JitterCompany/f1-led-circuit/firmware/f1-logic/README.md

# F1 Logic

Generate binary driver dataset from csv file

```bash
cargo run --bin csv_to_bin --features use-std
```

Test deserialization

```bash
cargo run --bin deserialize_in_chunks --features use-std
```
