JitterCompany/f1-led-circuit/kicad/schematics_block_diagram/schematics_block_diagram_v3.png

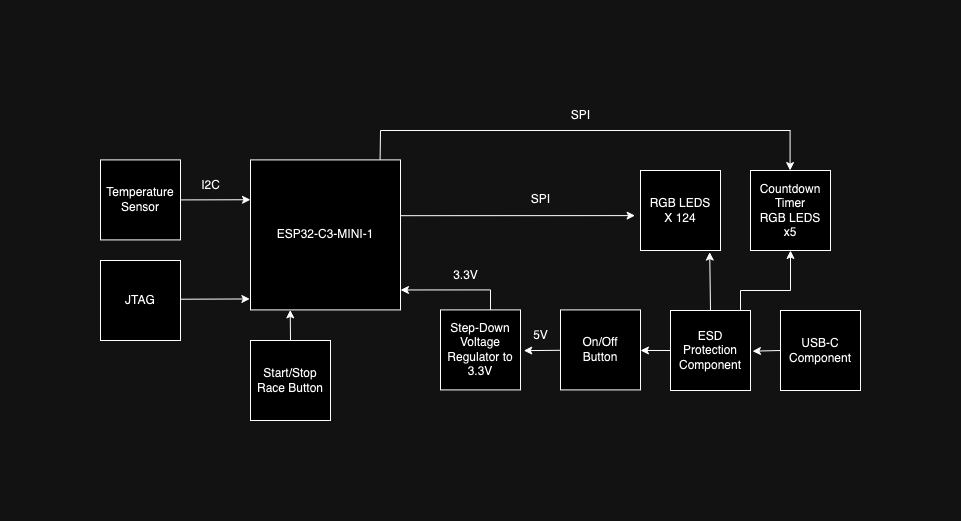
kicad/schematics_block_diagram/schematics_block_diagram_v3.png
