JitterCompany/f1-led-circuit/kicad/x_y_led_coords_zandvoort/zandvoort_kicad_import.png

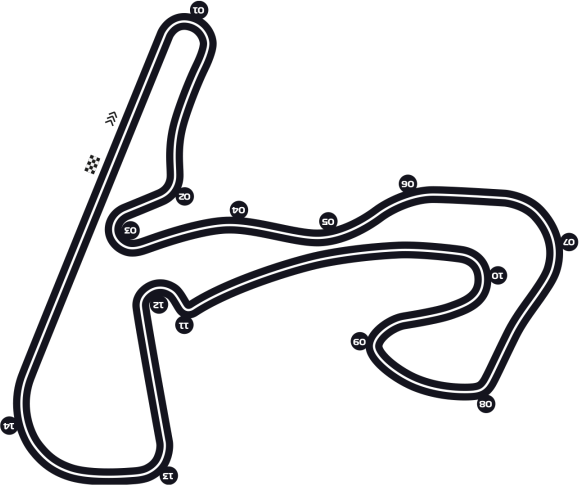
kicad/x_y_led_coords_zandvoort/zandvoort_kicad_import.png
