JitterCompany/f1-led-circuit/kicad/3D models/USB4105-GF-A.STEP

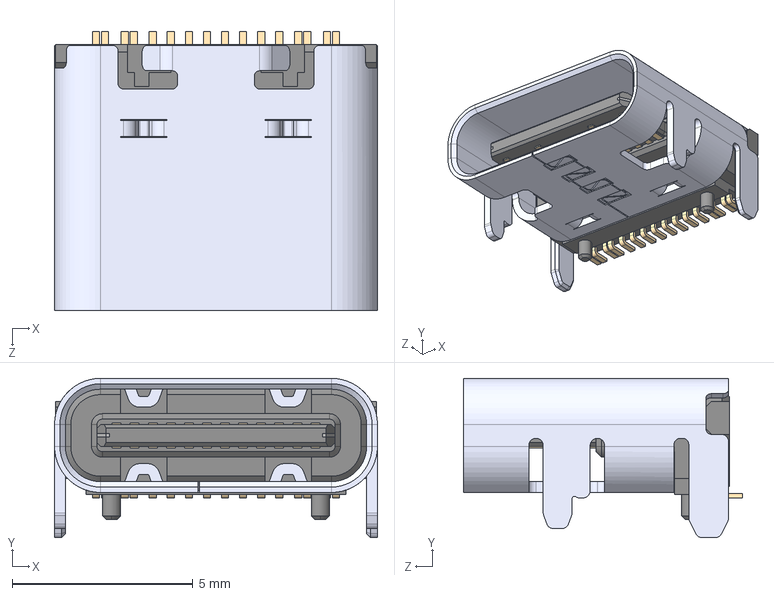
[picture p3: CAD file, 2024-05-20]
kicad/3D models/USB4105-GF-A.STEP
8.94 x 4.41 x 7.71 mm
