JitterCompany/f1-led-circuit/kicad/3D models/HD108-2020.step

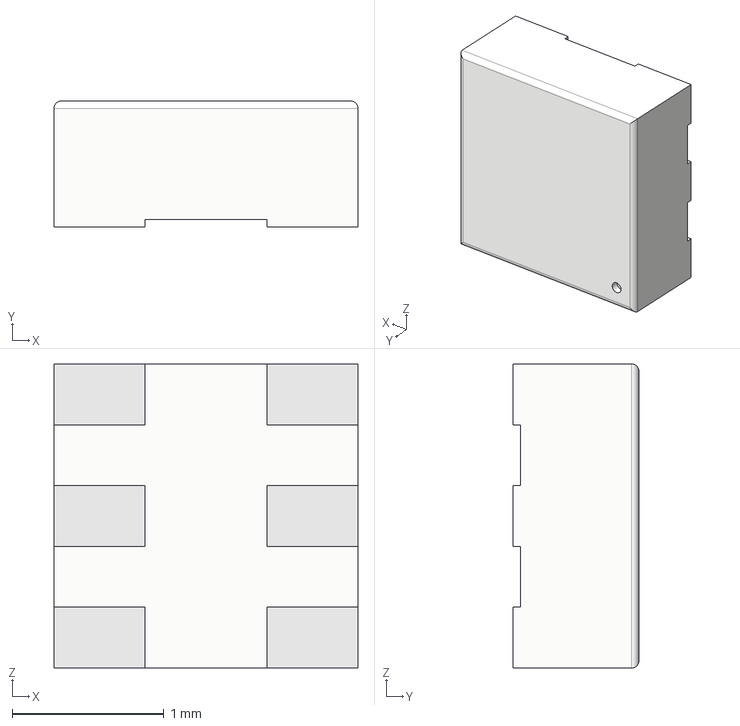
[picture p4: CAD file, 2024-05-20]
kicad/3D models/HD108-2020.step
2.00 x 0.83 x 2.00 mm
