JitterCompany/f1-led-circuit/kicad/3D models/ESP32-C3-MINI-1-N4.step

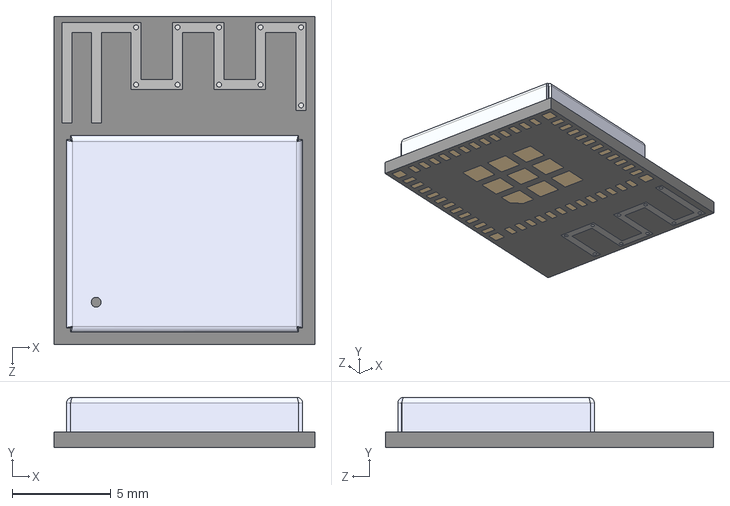
[picture p5: CAD file, 2024-05-20]
kicad/3D models/ESP32-C3-MINI-1-N4.step
13.2 x 2.55 x 16.6 mm
