JitterCompany/f1-led-circuit/kicad/3D models/TSM085P03CV.step

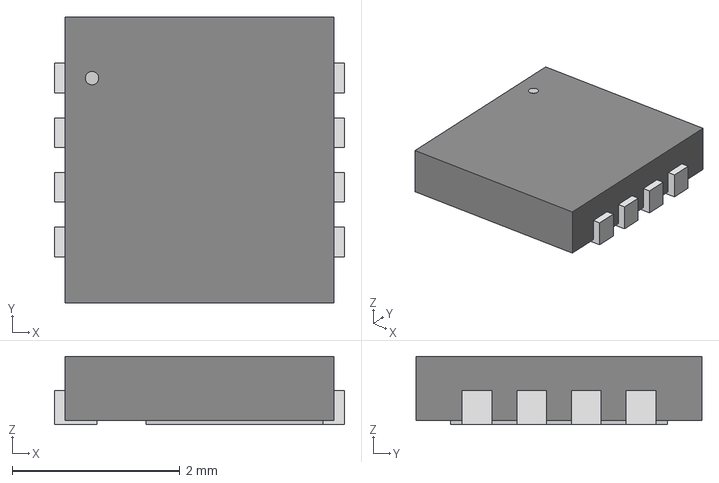
[picture p6: CAD file, 2024-05-20]
kicad/3D models/TSM085P03CV.step
3.45 x 3.40 x 0.815 mm
