JitterCompany/f1-led-circuit/kicad/3D models/LDLN050PU33R.step

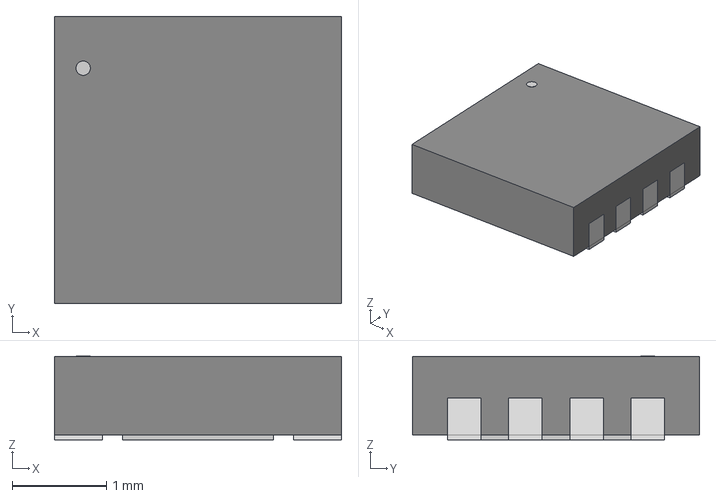
[picture p7: CAD file, 2024-05-20]
kicad/3D models/LDLN050PU33R.step
3.05 x 3.05 x 0.892 mm
