JitterCompany/f1-led-circuit/kicad/3D models/FTSH-105-01-L-DV-K-TR.step

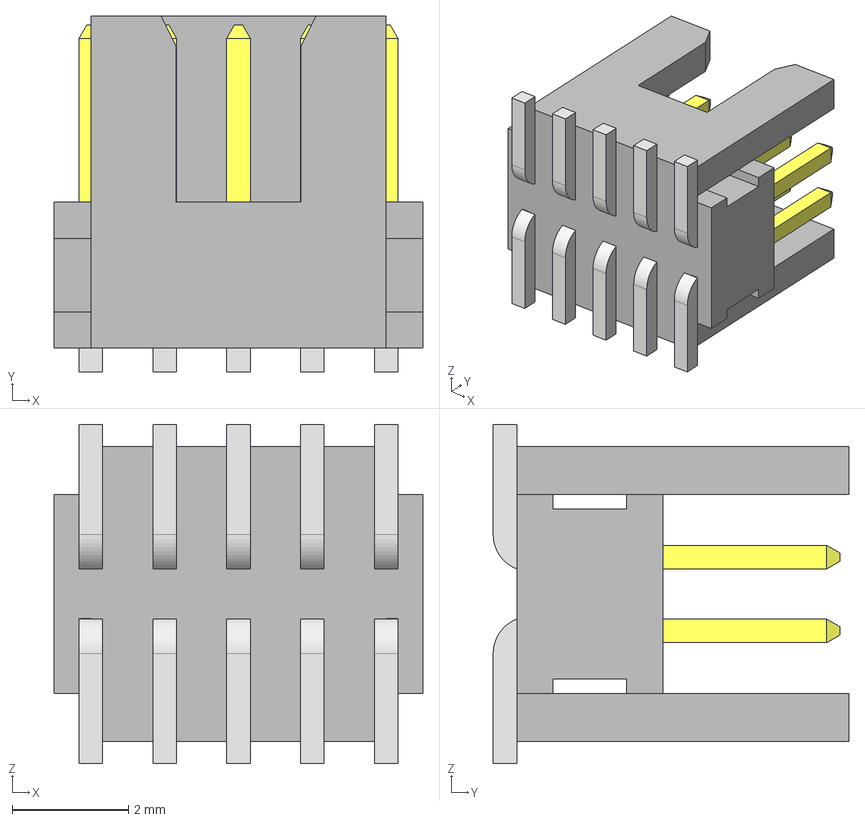
[picture p8: CAD file, 2024-05-20]
kicad/3D models/FTSH-105-01-L-DV-K-TR.step
6.35 x 6.12 x 5.84 mm
FTSH-105-01-L-DV-K-TR_body
FTSH-105-01-L-DV-K-TR_pins1
FTSH-105-01-L-DV-K-TR_pins2
