JitterCompany/f1-led-circuit/kicad/3D models/AS13AP.stp

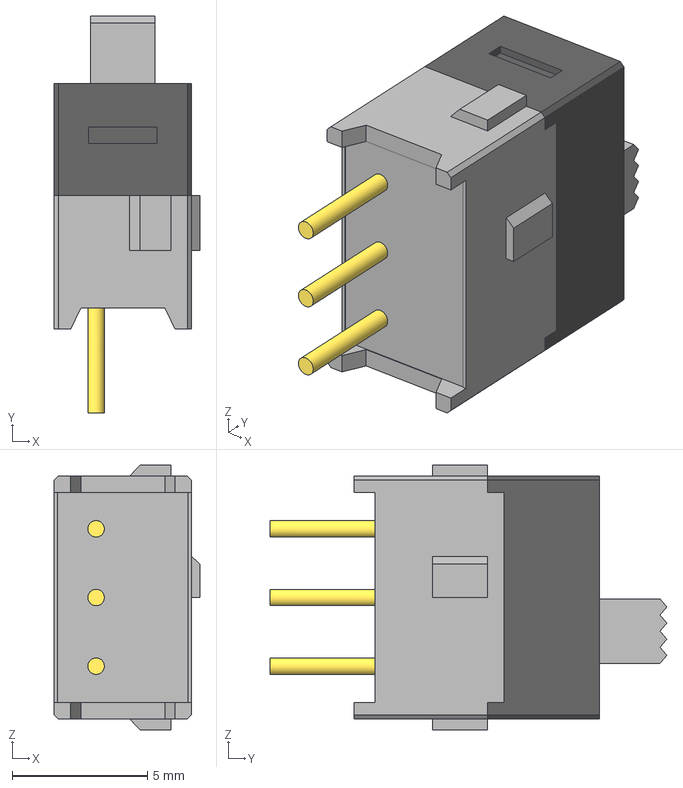
[picture p9: CAD file, 2024-05-20]
kicad/3D models/AS13AP.stp
5.38 x 14.7 x 9.80 mm
AS13APbody12
AS13APbody1
AS13APalong
AS13APp
