JitterCompany/f1-led-circuit/kicad/3D models/NUF2042XV6T1G.STEP

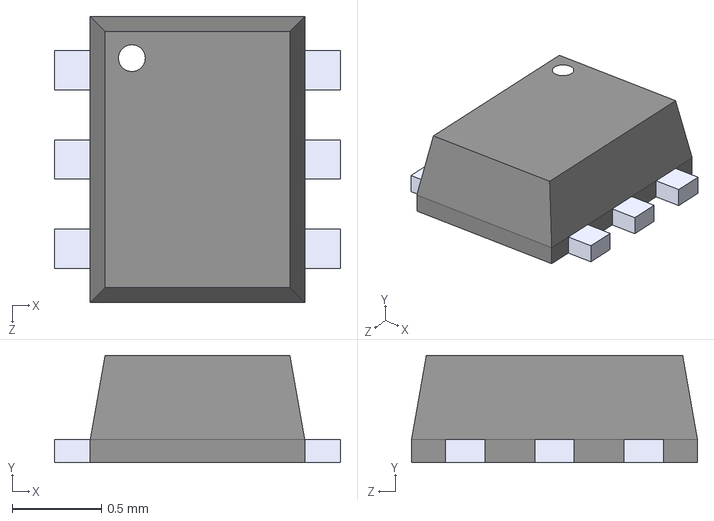
[picture p10: CAD file, 2024-04-30]
kicad/3D models/NUF2042XV6T1G.STEP
1.60 x 0.6 x 1.60 mm
