JitterCompany/f1-led-circuit/kicad/3D models/430182043816.stp

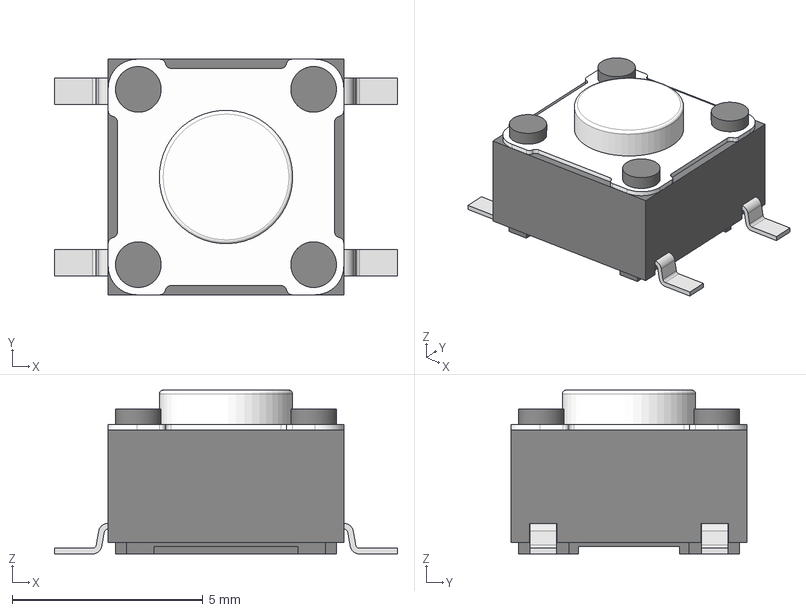
[picture p11: CAD file, 2024-05-20]
kicad/3D models/430182043816.stp
9.00 x 6.20 x 4.30 mm
