JitterCompany/f1-led-circuit/kicad/3D models/430182070816.stp

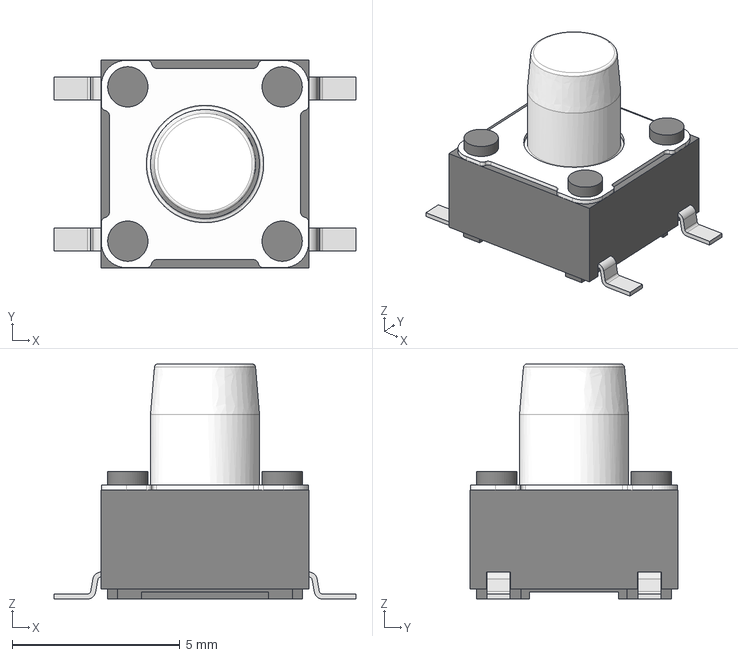
[picture p12: CAD file, 2024-05-20]
kicad/3D models/430182070816.stp
9.00 x 6.20 x 7.00 mm
