JitterCompany/f1-led-circuit/(threads)

Thread 1 (2024-04-01):

Select Microcontroller

CodingInGreen, 2024-04-01:

CodingInGreen, 2024-04-01:
I have experience getting Wifi connectivity working on an ESP32C3, which also supports  2.4 GHz Wi-Fi (802.11 b/g/n) and Bluetooth Low Energy (BLE) 5.0.

CodingInGreen, 2024-04-02:
probe-rs issue resolved, problem was caused by outdated probe-rs version. Board could be a good candidate.

CodingInGreen, 2024-04-03:
The design is open-source and we have the KiCAD files here:
https://github.com/esp-rs/esp-rust-board

ESP32-C3-MINI-1 comes with a PCB Antenna
ESP32-C3-MINI-1U comes with an external Antenna Connector

Power Supply Voltage:
Min: 3V
Typ: 3.3V
Max: 3.6V

ijager, 2024-04-03:
Does this part work well with RTIC and or Embassy?

CodingInGreen, 2024-04-03:
> Does this part work well with RTIC and or Embassy?

It works well with Embassy, I haven't tried RTIC with this specific MCU.

ijager, 2024-04-03:
Seems like the C3 is the only part in the ESP family that currently works with RTIC (due to the mcu architecture). And they also work with Embassy

I think this is good choice.

CodingInGreen, 2024-04-03:
Found a bug -- https://github.com/rtic-rs/rtic/pull/913

Someone in the chat notified me but I didn't see it until after, of a separate PR that covers it already that hasn't yet been merged -- https://github.com/rtic-rs/rtic/pull/906

haha, seems like we're probably set on RTIC as well. There's an updated example in #906 that I'll test out tomorrow.

CodingInGreen, 2024-04-09:
We've decided to choose the esp32c3 for our MCU.

Reasons why:

- 2.4 GHz Wi-Fi (802.11b/g/n) and Bluetooth® 5 (LE)
- Plays nicely with Embassy
- Configurable clock frequency with a maximum of 120 MHz in Single Transfer Rate (STR) mode (speedy enough for our LEDs)
- Adam has experience with esp32c3 through the dev kit: ESP32-C3-DevKit-RUST-1

CodingInGreen, 2024-04-14:
ESP32-C3-MINI-1 Selected

Closed 2024-04-14.

Thread 2 (2024-04-01):

Select LED

CodingInGreen, 2024-04-01:
We want to use addressable LEDs.

As far as we know there are two versions:

* Neopixel (WS2812, WS2813...)
* APA102
* ... Maybe there others?

They work with different protocols.

To make a selection we should make an overview of the available parts and figure out the differences between them.

* dimensions
* power requirements
* maximum daisy chained length?
* protocol
* Are they recommended for new designs (by the manufacturer)?
* ...

CodingInGreen, 2024-04-01:
https://www.iodparts.eu/part/ws2812b-2020

WS2812B-2020
Worldsemi
SMD 2mm x 2mm
Protocol: NZR communication mode
The control integrated circuit and the LED share the only power source.
12mA operating current per channel.
Stock: 102,785
Days to Ship: 20 Days
Minimum Order Quantity: 4,500 ??

https://www.digikey.pt/pt/products/detail/sunled/XZDGCBDMERK150W-1/15288282?productid=15288282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

XZDGCBDMERK150W-1
SunLED
SMD 1 mm x 1 mm
Forward Current: 10mA
Protocol: Not sure if these can even be daisy chained.
Stock: 7,754
Ships Immediately

CodingInGreen, 2024-04-01:
After reviewing: https://www.superlightingled.com/blog/category/addressable-led-strips/addressable-led-ic-comparison/

I'm not 100% if WS2812B-2020 is the best. The 2x2mm form factor is super nice. Each LED draws up to 12mA per channel, so with a 5V/10A power supply that's 10A/36mA = 277.7 LEDs. Taking 80% of that to be conservative, that's 222 LEDs.

ijager, 2024-04-01:
Why is it "the best"?

Some things to consider:

* supply voltage
* Is there a supported maximum chained length?
* What is the maximum refresh rate (fps) for certain lengths of chains? Or maybe in reverse, say we want to achieve 30Hz, how long can we make the chain. (Here you can see why requirements are important to have).

It would be nice to make a nice markdown table with a row for each candidate. So we can compare and make a data driven decision.

CodingInGreen, 2024-04-02:
[led_comparison.xlsx](https://github.com/JitterCompany/f1-led-circuit/files/14832341/led_comparison.xlsx)

Added comparison chart for review.

CodingInGreen, 2024-04-02:
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

552 LEDs in total

CodingInGreen, 2024-04-03:
If there are 20 cars on the track at a time, with a maximum current draw of 20 mA per channel with 3 channels. Max draw per RGB LED is 60 mA x 20 cars = Max draw from LEDs for all cars = 1,200 mA or 1.2 A

CodingInGreen, 2024-04-03:
**WS2812B-2020**

The WS2812B-2020 LED utilizes a single-wire non-return-to-zero (NZR) communication mode, making its protocol highly sensitive to timing. This design means that the difference between transmitting a logic '0' or a '1' depends on precise timing intervals, which can introduce complexity in programming, especially on platforms with non-deterministic timing behavior. The protocol's timing sensitivity requires careful management of interrupts and timing functions to achieve stable color patterns and refresh rates, potentially complicating development on multitasking operating systems or environments with variable execution times.

**APA102C**

Conversely, the APA102C employs a two-wire protocol, similar to SPI, using separate data and clock lines, which significantly reduces timing sensitivity and programming complexity. This approach allows for more straightforward and reliable data transmission, making it less prone to errors from timing discrepancies. The inclusion of a clock line not only facilitates higher refresh rates by supporting faster data transmission but also enables the APA102C to operate with a broader range of microcontrollers and software environments, making it a more versatile choice for projects requiring robust and dynamic LED displays.

ijager, 2024-04-03:
This is great. I will inquire about availability and pricing for these parts so we weigh that into the selection.

ijager, 2024-04-03:
For power, assuming only 20 leds are on is too optimistic. We have to be able to handle turning on all LEDs, which can happen because of bugs or when people are going to run their own firmware on the board.

We can add a temperature sensor to monitor the board temperature and shut it down when it gets too hot.

CodingInGreen, 2024-04-04:
I recounted the LEDs for the track on the 300 x 300 pixel grid, and came up with 550 LEDs instead of 552.

550 LEDs x 60mA = 33,000mA or 33 Amps

CodingInGreen, 2024-04-08:
[led_comparison_updated.xlsx](https://github.com/JitterCompany/f1-led-circuit/files/14903831/led_comparison_updated.xlsx)

New Candidates:

SK9822-EC20(SK9822-2020)
APA107-2020
NS107S-2020
HD108-2020
EC20-6812 (SK6812-2020)

CodingInGreen, 2024-04-14:
HD108-2020 selected.

Closed 2024-04-14.

Thread 3 (2024-04-01):

Formulate Requirements

ijager, 2024-04-01:
Currently, we know the high level requirements vaguely. But we should write them down in a detailed and testable/measurable way.

CodingInGreen, 2024-04-04:
**Requirements**

- 20 LEDS for starting grid
- Countdown timer
- Connects to Wifi for any user's router
- Get a dataset outside of the system
- Have method to distinguish drivers
- Handle scenario where a car is out of race
- PCB shuts down if a maximum temperature is reached
- Passes standard EMC/ESD tests
- On/Off Button for User
- Start/Stop Button for User
- Show visual state of program - running or not
- Firmware should know its own version
- Firmware should be able to detect PCB version
- Debuggable with RTT
- Wall outlet to USB-C adapter
- LED driver is safe

Closed 2024-04-18.

Thread 5 (2024-04-11):

Select Temperature Sensor

CodingInGreen, 2024-04-11:
I have had a successful experience using an SHT31 temperature and humidity sensor using I2C.

SHT31:

[https://www.digikey.pt/pt/products/detail/sensirion-ag/SHT31-DIS-F2.5KS/6212137?productid=6212137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](url)

This is the crate I used:

https://crates.io/crates/sht31

ijager, 2024-04-11:
Is this crate usable in an async project?On 11 Apr 2024, at 18:30, Adam Hott ***@***.***> wrote:
I have had a successful experience using an SHT31 temperature and humidity sensor using I2C.
SHT31:
https://www.digikey.pt/pt/products/detail/sensirion-ag/SHT31-DIS-F2.5KS/6212137?productid=6212137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
This is the crate I used:
https://crates.io/crates/sht31

—Reply to this email directly, view it on GitHub, or unsubscribe.You are receiving this because you are subscribed to this thread.Message ID: ***@***.***>

CodingInGreen, 2024-04-14:
This builds successfully, I didn't connect my SHT31 sensor to the board to test though.

Would you like me to do that to see if I can get a reading?

https://github.com/CodingInGreen/esp32c3-embassy-sht31

CodingInGreen, 2024-04-15:
I will test the SHT31. Maybe the BME280 sensor would be a better choice.

This crate supports embedded-hal-async as well:
https://crates.io/crates/bme280-rs

I don't have a BME280 on hand, here is it available in Portugal (18,10 euros + shipping is about 5 euros = 23.10 euros).
https://mauser.pt/catalog/product_info.php?products_id=096-6714

It could arrive in 2-3 days.

CodingInGreen, 2024-04-15:
I had some trouble getting the readings on esp32c3, so I tested on the micro:bit V2.

I got an average time measurement: timestamp of data collection cycle - timestamp of new reading = 98 milliseconds.

The micro:bit V2 has a clock speed of 64 Mhz and the measurement frequency can be set up to 400 Mhz (limited by the IC2 setup on the micro:bit V2 crate).

The clock speed of esp32-c3-mini-1 is 160 Mhz, and the maximum measurement frequency of the SHT31 is 1 Mhz.

Calculate for estimate for the blocking time on the esp32-c3-mini-1:

CPU speed increase from 64 MHz to 160 MHz (a factor of 2.5)
I2C speed increase from 400 kHz to 1 MHz (a factor of 2.5)

Time reduction = 2.5 x 2.5 = 6.25

98 milliseconds (avg. time from micro:bit V2) / 6.25 = 15.68 milliseconds

Estimated average blocking time - around 15 milliseconds

CodingInGreen, 2024-04-18:
We went with MCP9701A as it's been successfully used in other projects, and has a margin of error that is acceptable.

Closed 2024-04-18.

Thread 6 (2024-04-15):

Select Power Adapter and Voltage Regulator/Buck Converter

CodingInGreen, 2024-04-15:
We need to calculate the maximum current consumption for the board and select the appropriate power adapter and voltage regulator/buck converter.

Closed 2024-04-18.

Thread 7 (2024-04-18):

Select Start/Stop Button

CodingInGreen, 2024-04-18:
[4301x2xxx8x6.pdf](https://github.com/JitterCompany/f1-led-circuit/files/15025002/4301x2xxx8x6.pdf)

Wurth Elektronik
Series: Tact Switches
Part Number: 430 182 070 816

Closed 2024-04-18.

Thread 18 (2024-05-22):

Zandvoort dataset for testing

CodingInGreen, 2024-05-22:
For the data pulled from https://openf1.org/

Attached is are the data points for the x, y, and z coordinates as well as the corresponding timestamp for Max Verstappen's results from the 2023 Dutch Grand Prix.

[zandvoort_data.csv](https://github.com/JitterCompany/f1-led-circuit/files/15403007/zandvoort_data.csv)

Here is how I generated this data:
https://github.com/CodingInGreen/f1-led-circuit-track-data

I attempted to plot the data here:
https://github.com/CodingInGreen/f1-led-circuit-track-plot/blob/main/zandvoort_track.png

But as you can see the plot doesn't represent anything close to the actual track's form.

There are positive and negative integers as the x and y coordinates, so we need to find the origin (0,0) for this data.

There is a separate project that is successfully mapping the data to the form of the track, it's open source, but they haven't yet built out the track for Zandvoort so you can see in this example if you select the 2023 race for the Zandvoort track the 3D car drives around without a track:
https://www.f1nsight.com/
https://github.com/adityakotha03/F1nsight

We discussed the possibility of live data streaming over Wifi. The owner of the openf1 repository says that there IS access to real-time data during the race.

https://github.com/br-g/openf1/discussions/46

CodingInGreen, 2024-05-23:
I was pulling in the incorrect track's dataset, the repository has been updated with the correct id and I was able to pull and plot the correct data. See https://github.com/JitterCompany/f1-led-circuit/issues/19

CodingInGreen, 2024-05-23:
Closing this to move over to Issue #19

Closed 2024-05-23.

Thread 19 (2024-05-23):

Mapping Zandvoort track data to led positions

CodingInGreen, 2024-05-23:
I first output to a .csv file the coordinates for the x,y positions of the LED footprints from KiCad. I set the origin to be offset by the KiCad x, y coordinate of the bottom left PCB edge corner, so that we'd be dealing with only positive x and y coordinates.

This is the script to get that data:
https://github.com/JitterCompany/f1-led-circuit/blob/master/kicad/x_y_led_coords_zandvoort/get_x_y_from_origin.py

I then output to a .csv file the dataset from the race data from Max Verstappen's 2023 Dutch Grand Prix at Zandvoort using program:
https://github.com/CodingInGreen/f1-led-circuit-track-data/blob/main/src/main.rs

I then plotted that data using this program:
https://github.com/CodingInGreen/f1-led-circuit-track-plot/blob/main/src/main.rs

Which gave me this plot:
https://github.com/CodingInGreen/f1-led-circuit-track-plot/blob/main/zandvoort_track_adjusted.png

I then normalized the x,y coordinates of the output from the KiCad led footprint positions to the track data using this program:
https://github.com/CodingInGreen/f1-led-circuit-normalize-data/blob/master/src/main.rs

And plotted the led positions using this program:
https://github.com/CodingInGreen/f1-led-circuit-plot-leds/blob/master/src/main.rs

Which gave me this plot:
https://github.com/CodingInGreen/f1-led-circuit-plot-leds/blob/master/led_plot_adjusted.png

The next step correlate the led positions with the track data.

CodingInGreen, 2024-05-23:
This program adds the LED designators to the x,y,timestamp data of the 2023 Zandvoort Max Verstappen data.

https://github.com/CodingInGreen/f1-led-circuit-nearest-neighbor/blob/master/src/main.rs

CodingInGreen, 2024-05-29:
I then used this program to combine the datasets of the actual race data and the x,y coordinates of the leds.

https://github.com/CodingInGreen/f1-led-circuit-combined-x-y-data

Thread 20 (2024-05-31):

KiCad PCB Layout - ESD Protection Component - NUF2042XV6T1G - footprint does not match component dimensions

CodingInGreen, 2024-05-31:
Here is the datasheet with the proper dimensions of the component:

[NUF2030XV6_D-2319419.pdf](https://github.com/user-attachments/files/15511314/NUF2030XV6_D-2319419.pdf)

In the current pcb layout the footprint dimensions are slightly off from the component dimensions.

We will hand solder the component as it is very close to fitting or leave it off the board.

CodingInGreen, 2024-08-05:
Fixed

Closed 2024-08-05.

Thread 21 (2024-06-14):

Create basic HD108 example

CodingInGreen, 2024-06-14:
Requirement - Turn one HD108-2020 LED of the f1-led-circuit board a specific RGB color.

CodingInGreen, 2024-06-15:
I found this documentation regarding migration from embedded-hal 0.2 to 1.0 regarding SpiDevice and SpiBus.

https://github.com/rust-embedded/embedded-hal/blob/master/docs/migrating-from-0.2-to-1.0.md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

CodingInGreen, 2024-06-15:
I worked on ensuring the correct traits from embedded-hal and embedded-hal-async were implemented. This included creating a wrapper around the spi instance to adapt it to the SpiBus trait required by the HD108 driver. It seems there is a mismatch between the expected traits between embedded-hal-async and the esp-hal library. The HD108 driver required an implementation of the SpiBus trait from embedded-hal-async, but the SPI implementation in esp-hal did not directly conform to this trait. The SpiBus trait has methods like read, write, transfer, transfer_in_place, and flush, which are asynchronous. The esp-hal library provides synchronous methods that needed to be wrapped or adapted. I had many attempts but was unable to successfully create a working wrapper.

ijager, 2024-06-16:
You cannot really wrap a sync API in order to make it _async_. Because for async you need a WAKER that can notify the async runtime that it is done with the `await` part.

CodingInGreen, 2024-06-16:
Can we use this? It has a SpiBus trait.

https://docs.embassy.dev/embassy-embedded-hal/git/default/adapter/index.html

ijager, 2024-06-17:
Sure for a first demo, definitely

Closed 2024-06-18.

Thread 24 (2024-06-19):

Loop over LEDs - light up one at a time for all LEDs on board - HD108

CodingInGreen, 2024-06-19:
1. Limit brightness
2. Change function to pub async fn make_red(&mut self, led_num: usize) -> Result<(), SPI::Error> and loop over all LEDs (so only 1 at a time is on)

CodingInGreen, 2024-06-19:
Having power/connectivity issues with board 1, testing board 2.

Closed 2024-06-19.

Thread 36 (2024-06-28):

Format race data

CodingInGreen, 2024-06-28:

CodingInGreen, 2024-06-28:
The location data provides the timestamps and x,y,z coordinates per driver, it also provides the driver number. Unfortunately we can't pull all of the location  data down at once because the API server has a timeout after 1 minute.

This is the format of the API URL to request the location data for Max Verstappen for the 2023 Dutch Grand Prix:

https://api.openf1.org/v1/location?session_key=9149&driver_number=1

The format is json.

The format looks like this:
[{"x":0,"y":0,"z":0,"driver_number":1,"date":"2023-08-27T12:01:01.614000+00:00","session_key":9149,"meeting_key":1217},{next json objects until end}]

CodingInGreen, 2024-06-28:
We want to combine the datasets for all the drivers sorted by timestamp. Then we have the full dataset, but it's missing the led numbers for the driver. There should be a mapping between the x,y coordinates int the source dataset and the led's x,y coordinates (which we need to calculate).

CodingInGreen, 2024-06-28:
Once we've arrived at a new dataset with the timestamp, driver number, and led number, this is all the data that we need to convert it to the format that we want to use for processing. We can discard the remain fields in the dataset.

CodingInGreen, 2024-06-28:
Then we want to convert the dataset with the timestamp, driver number, and led number to a new format that we can use for processing. This is tricky, because the timestamps in the dataset across drivers aren't in sync. So we need a way to normalize the timestamps for a certain period of time (50 ms, 100ms, 250 ms, etc.). The results will be that we have multiple driver numbers and led locations for each timestamp, which would constitute an "UpdateFrame" for processing on the physical board's led lights.

CodingInGreen, 2024-06-28:
This is the format that we want to arrive at, at the end of this process. As you can see, each UpdateFrame corresponds to a sample of the source dataset for a given period of time based upon the normalization of timestamps across drivers and based upon a possible nearest neighbor calculation to map the led lights on the board to the x,y coordinates in the source dataset for that period of time.

`#[derive(Debug)]
pub struct DriverData {
    pub driver_number: u32,
    pub led_num: u32,
}

#[derive(Debug)]
pub struct UpdateFrame {
    pub drivers: [Option<DriverData>; 20],
}

#[derive(Debug)]
pub struct VisualizationData {
    pub update_rate_ms: u32,
    pub frames: [UpdateFrame; 1548],
}

pub const VISUALIZATION_DATA: VisualizationData = VisualizationData {
    update_rate_ms: 1000,
    frames: [
        UpdateFrame {
            drivers: [
                Some(DriverData {
                    driver_number: 23,
                    led_num: 53,
                }),
                Some(DriverData {
                    driver_number: 14,
                    led_num: 31,
                }),
                Some(DriverData {
                    driver_number: 77,
                    led_num: 70,
                }),
                Some(DriverData {
                    driver_number: 10,
                    led_num: 49,
                }),
                Some(DriverData {
                    driver_number: 24,
                    led_num: 8,
                }),
                Some(DriverData {
                    driver_number: 44,
                    led_num: 52,
                }),
                Some(DriverData {
                    driver_number: 27,
                    led_num: 48,
                }),
                Some(DriverData {
                    driver_number: 40,
                    led_num: 34,
                }),
                Some(DriverData {
                    driver_number: 16,
                    led_num: 85,
                }),
                Some(DriverData {
                    driver_number: 20,
                    led_num: 64,
                }),
                Some(DriverData {
                    driver_number: 4,
                    led_num: 51,
                }),
                Some(DriverData {
                    driver_number: 31,
                    led_num: 14,
                }),
                Some(DriverData {
                    driver_number: 11,
                    led_num: 52,
                }),
                Some(DriverData {
                    driver_number: 81,
                    led_num: 77,
                }),
                Some(DriverData {
                    driver_number: 63,
                    led_num: 56,
                }),
                Some(DriverData {
                    driver_number: 55,
                    led_num: 3,
                }),
                Some(DriverData {
                    driver_number: 2,
                    led_num: 47,
                }),
                Some(DriverData {
                    driver_number: 18,
                    led_num: 27,
                }),
                Some(DriverData {
                    driver_number: 22,
                    led_num: 25,
                }),
                Some(DriverData {
                    driver_number: 1,
                    led_num: 45,
                }),
            ],
        },`

CodingInGreen, 2024-07-02:
I updated created a handmade data structure/dataset for processing the leds, and I reviewed that against the computer made data structure/dataset. The two didn't match, so I revised the processing program, for this one the data structures/datasets match:

https://github.com/CodingInGreen/f1-led-circuit-format-data-finalized

I then processed the sample dataset using that program and tested on the board.

The behavior matches more closely with the race, but I need to review the race tracker alongside the board running the program.

CodingInGreen, 2024-07-02:
One of the problems I discovered is that I was omitting 0,0 x,y coordinate timestamps in the original dataset for processing. This was throwing off the order of timestamps, in looking at the raw data there actually are matching timestamps, in many cases for all 20 drivers. It then becomes easy to consolidate those timestamps into an UpdateFrame for processing.

CodingInGreen, 2024-07-02:
So we need to decide how to handle the 0,0 x,y timestamp data. We can't omit it, currently the nearest neighbor is led number 41 on the pcb. One thing we might do is assign a led number that is out of range, for example 97 doesn't map to an led number. Then we could handle that special case in hd108.rs if needed.

CodingInGreen, 2024-07-02:
We decided for the time being to set 0,0 x,y positions to led number 97.

Closed 2024-07-27.

Thread 42 (2024-08-03):

Remove unnecessary components

ijager, 2024-08-03:
- JTAG connector (But perhaps we can expose these pins with some test points on the backside)
- JP1 jumper: same, expose with testpoints
- Boot button: expose pin via test-point

Let's go for standard 2.54 pitch between these test points.

Place all test points in a row close to the board edge to be used with a test clip.

[https://www.fshh1688.com/1-27mm-pitch-test-stand-pcb-clip-clamp-fixture-fixture-probe[…]-program-burn-2pin-3pin-4pin-5pin-6pin-7pin-8pin-9pin-10pin/](https://www.fshh1688.com/1-27mm-pitch-test-stand-pcb-clip-clamp-fixture-fixture-probe-pogo-pin-download-program-burn-2pin-3pin-4pin-5pin-6pin-7pin-8pin-9pin-10pin/)

CodingInGreen, 2024-08-08:
I added changed those items to test points in the schematic, can you check them and let me know if they are correct?

CodingInGreen, 2024-08-08:
I've updated the PCB layout, just pushed the changes.

I'm not sure if there is a standard order for the test points to be in, or if the layout order for the test points matters?

Can you take a quick look when you have a chance?

ijager, 2024-08-08:
This looks an extra GND and 3V3 testpoint to the JTAG series

CodingInGreen, 2024-08-08:
Ok added! Let me know if we can close this issue please. Thanks!

Closed 2024-08-08.

Thread 43 (2024-08-03):

Add 3D models to all footprints used

ijager, 2024-08-03:

CodingInGreen, 2024-08-08:
The 3D models are here, I just forgot how to load them in KiCad PCB Layout editor.

https://github.com/JitterCompany/f1-led-circuit/tree/master/kicad/3D%20models

ijager, 2024-08-08:
The path to the 3d files in the footprint should be correct. I think we can use `${KIPRJMOD}` to point to the current project directory.

https://docs.kicad.org/8.0/it/pcbnew/pcbnew_footprints_and_libraries.html

Thread 44 (2024-08-03):

Silkscreen

ijager, 2024-08-03:
- [ ] Remove all designators
- [ ] Add Turn numbers and names

CodingInGreen, 2024-08-08:
Does the manufacturer have limitations on what fonts can be used, or do they support any font that KiCad can handle?

ijager, 2024-08-08:
It is more about the resolution they can print. Kicad already handles the conversion of font to gerber file

Thread 45 (2024-08-03):

Use ESP32 with on-board antenna

ijager, 2024-08-03:
The current ESP only has a WFL connector. Replace it with the version with antenna.

The footprint is already correct probably. Just need to use the correct part number.

Double check the footprint.

CodingInGreen, 2024-08-05:
Updated part number, footprint is the same.

Closed 2024-08-05.

Thread 46 (2024-08-03):

Add margin so PCB can possibly be mounted in a photo frame

ijager, 2024-08-03:

CodingInGreen, 2024-08-05:
Fixed

Closed 2024-08-05.

Thread 47 (2024-08-03):

Change on/off slide switch

ijager, 2024-08-03:
Current one is too big/ too high.

We need to find a more subtle one, that blends in better with the rest of the components.

CodingInGreen, 2024-08-07:
Found this one:

https://pt.mouser.com/ProductDetail/Diptronics/SS3NP-MSC-V-T-R?qs=wnTfsH77Xs7Og0A6q%252BLbmQ%3D%3D

CodingInGreen, 2024-08-08:
Found this one as well:

ijager, 2024-08-08:
Actually how about just getting rid of the button and MOSFET. We already haver the start/stop button. No need to further confuse the user. And we save some components.

ijager, 2024-08-08:
Yes exactly

CodingInGreen, 2024-08-08:
Ok, I removed the power switch and cleaned up the schematic/pcb layout.

Thread 48 (2024-08-03):

Improve component placement for improved aesthetics

ijager, 2024-08-03:
Ideally the non-LED components could represent some buildings around the track.

- USB C connector should probably still face downwards

CodingInGreen, 2024-08-08:
How about the power components, do they need to be close together near the USB-C Connector?

ijager, 2024-08-08:
Since we decided to put those on the back I suggest to keep them close together so that a cutout in the backplane can remain small

CodingInGreen, 2024-08-08:
There are quite a few capacitors that will live inside the LED race track, if we choose to utilize them.

What are your thoughts on whether we will have the boards built with capacitors already on the boards, or just the pads?

ijager, 2024-08-08:
Maybe we can remove them or place them on the bottom

CodingInGreen, 2024-08-08:
With a 4 layer PCB I'd like to place them on the bottom and try it, sound okay?

CodingInGreen, 2024-08-09:
Actually if we can remove them we can save on components cost.

Thread 49 (2024-08-03):

Create Startup Animation

ijager, 2024-08-03:
A task that is run at startup that lights up all LEDs

Either

* All at once at low brightness
* A small train of LEDs slowly going around the track

Or both.

In order to accomplish this we probably need to split up the actual led driving part in a separate task so that we don't need to share the resources between tasks.

ijager, 2024-08-07:
Proposed Tasks

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

`led-task`: Owns the HD108 driver. Does not know about (racing)drivers or about a race. Just knows about leds and about the update rate. takes one frame from the channel and updates the LEDs every `update_rate`.

`startup-anim-task`: Generates a list of frames it wants to to show and sends it on the queue. If queue is full `await` until there is new space.

`race-task`: reads race data from flash and creates the frames. Knows about racing drivers and colors.

Closed 2024-08-08.

Thread 50 (2024-08-03):

Temperature sensor: working example

ijager, 2024-08-03:
Just to show that the current hardware is correct. Does not yet have to integrate with the rest of the firmware

CodingInGreen, 2024-08-06:
Making a note to double check foot print for temperature sensor. MCP9701AT-E/LT is the correct part number.

Datasheet here: http://ww1.microchip.com/downloads/en/DeviceDoc/20001942G.pdf

Closed 2024-08-06.
