JitterCompany/f1-led-circuit/firmware/examples/f1-wifi/src/main.rs

#![no_std]
#![no_main]
#![feature(type_alias_impl_trait)]

extern crate alloc;
use esp_hal as hal;
use hal::{clock::ClockControl, embassy, peripherals::Peripherals, prelude::*, timer::TimerGroup, Rng};
use core::mem::MaybeUninit;
use esp_backtrace as _;
use esp_println::println;


use esp_wifi::{initialize, EspWifiInitFor};
use esp_wifi::wifi::{
    ClientConfiguration, Configuration, WifiController, WifiDevice, WifiEvent,
    WifiStaDevice, WifiState,
};


use embassy_executor::Spawner;
use embassy_time::{Duration, Timer};
use embassy_net::{Config, Stack, StackResources};

use static_cell::make_static;


#[global_allocator]
static ALLOCATOR: esp_alloc::EspHeap = esp_alloc::EspHeap::empty();


fn init_heap() {
    const HEAP_SIZE: usize = 32 * 1024;
    static mut HEAP: MaybeUninit<[u8; HEAP_SIZE]> = MaybeUninit::uninit();

    unsafe {
        ALLOCATOR.init(HEAP.as_mut_ptr() as *mut u8, HEAP_SIZE);
    }
}

const SSID: &str = env!("SSID");
const PASSWORD: &str = env!("PASSWORD");

#[main]
async fn main(spawner: Spawner) -> ! {
    esp_println::logger::init_logger(log::LevelFilter::Info);

    let peripherals = Peripherals::take();

    let system = peripherals.SYSTEM.split();
    let clocks = ClockControl::max(system.clock_control).freeze();

    let rng = Rng::new(peripherals.RNG);

    let timer = hal::systimer::SystemTimer::new(peripherals.SYSTIMER).alarm0;
    let init = initialize(
        EspWifiInitFor::Wifi,
        timer,
        rng,
        system.radio_clock_control,
        &clocks,
    )
    .unwrap();

    let wifi = peripherals.WIFI;
    let (wifi_interface, controller) =
        esp_wifi::wifi::new_with_mode(&init, wifi, WifiStaDevice).unwrap();

    let timer_group0 = TimerGroup::new(peripherals.TIMG0, &clocks);
    embassy::init(&clocks, timer_group0);

    let config = Config::dhcpv4(Default::default());

    let seed = 1234; // very random, very secure seed

    // Init network stack
    let stack = &*make_static!(Stack::new(
        wifi_interface,
        config,
        make_static!(StackResources::<3>::new()),
        seed
    ));

    spawner.spawn(connection(controller)).ok();
    spawner.spawn(net_task(&stack)).ok();

    loop {
        if stack.is_link_up() {
            break;
        }
        Timer::after(Duration::from_millis(500)).await;
    }

    println!("Waiting to get IP address...");
    loop {
        if let Some(config) = stack.config_v4() {
            println!("Got IP: {}", config.address);
            break;
        }
        Timer::after(Duration::from_millis(500)).await;
    }

    loop {

    }
}

#[embassy_executor::task]
async fn connection(mut controller: WifiController<'static>) {
    println!("start connection task");
    println!("Device capabilities: {:?}", controller.get_capabilities());

    loop {
        match esp_wifi::wifi::get_wifi_state() {
            WifiState::StaConnected => {
                // wait until we're no longer connected
                controller.wait_for_event(WifiEvent::StaDisconnected).await;
                Timer::after(Duration::from_millis(5000)).await
            }
            _ => {}
        }
        if !matches!(controller.is_started(), Ok(true)) {
            let client_config = Configuration::Client(ClientConfiguration {
                ssid: SSID.try_into().unwrap(),
                password: PASSWORD.try_into().unwrap(),
                auth_method: if PASSWORD.is_empty() { esp_wifi::wifi::AuthMethod::None } else { Default::default() },
                ..Default::default()
            });

            controller.set_configuration(&client_config).unwrap();
            println!("Starting wifi");
            controller.start().await.unwrap();
            println!("Wifi started!");
        }
        println!("About to connect...");

        match controller.connect().await {
            Ok(_) => println!("Wifi connected!"),
            Err(e) => {
                println!("Failed to connect to wifi: {e:?}");
                Timer::after(Duration::from_millis(5000)).await
            }
        }
    }
}


#[embassy_executor::task]
async fn net_task(stack: &'static Stack<WifiDevice<'static, WifiStaDevice>>) {
    stack.run().await
}
