JitterCompany/f1-led-circuit/firmware/f1-simulation/src/led_data.rs

#[derive(Debug, Clone)]
pub struct LedCoordinate {
    pub x_led: f32,
    pub y_led: f32,
    pub led_number: u32,
}

#[derive(Debug, Clone)]
pub struct UpdateFrame {
    pub timestamp: u64,
    pub led_states: Vec<(u32, (u8, u8, u8))>,
}

impl UpdateFrame {
    pub fn new(timestamp: u64) -> Self {
        Self {
            timestamp,
            led_states: Vec::new(),
        }
    }

    pub fn set_led_state(&mut self, led_number: u32, color: (u8, u8, u8)) {
        self.led_states.push((led_number, color));
    }
}

pub const LED_DATA: &[LedCoordinate] = &[
    LedCoordinate {
        x_led: 6413.0,
        y_led: 33.0,
        led_number: 1,
    },
    LedCoordinate {
        x_led: 6007.0,
        y_led: 197.0,
        led_number: 2,
    },
    LedCoordinate {
        x_led: 5652.0,
        y_led: 444.0,
        led_number: 3,
    },
    LedCoordinate {
        x_led: 5431.0,
        y_led: 822.0,
        led_number: 4,
    },
    LedCoordinate {
        x_led: 5727.0,
        y_led: 1143.0,
        led_number: 5,
    },
    LedCoordinate {
        x_led: 6141.0,
        y_led: 1268.0,
        led_number: 6,
    },
    LedCoordinate {
        x_led: 6567.0,
        y_led: 1355.0,
        led_number: 7,
    },
    LedCoordinate {
        x_led: 6975.0,
        y_led: 1482.0,
        led_number: 8,
    },
    LedCoordinate {
        x_led: 7328.0,
        y_led: 1738.0,
        led_number: 9,
    },
    LedCoordinate {
        x_led: 7369.0,
        y_led: 2173.0,
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
    },
    LedCoordinate {
        x_led: 7831.0,
        y_led: 3476.0,
        led_number: 85,
    },
    LedCoordinate {
        x_led: 8241.0,
        y_led: 3335.0,
        led_number: 86,
    },
    LedCoordinate {
        x_led: 8549.0,
        y_led: 3025.0,
        led_number: 87,
    },
    LedCoordinate {
        x_led: 8703.0,
        y_led: 2612.0,
        led_number: 88,
    },
    LedCoordinate {
        x_led: 8662.0,
        y_led: 2173.0,
        led_number: 89,
    },
    LedCoordinate {
        x_led: 8451.0,
        y_led: 1785.0,
        led_number: 90,
    },
    LedCoordinate {
        x_led: 8203.0,
        y_led: 1426.0,
        led_number: 91,
    },
    LedCoordinate {
        x_led: 7973.0,
        y_led: 1053.0,
        led_number: 92,
    },
    LedCoordinate {
        x_led: 7777.0,
        y_led: 664.0,
        led_number: 93,
    },
    LedCoordinate {
        x_led: 7581.0,
        y_led: 275.0,
        led_number: 94,
    },
    LedCoordinate {
        x_led: 7274.0,
        y_led: -35.0,
        led_number: 95,
    },
    LedCoordinate {
        x_led: 6839.0,
        y_led: -46.0,
        led_number: 96,
    },
];
