JitterCompany/f1-led-circuit/(commit log)

2024-04-10 Add KiCad Project - F1 LED Circuit
    [f1-led-circuit.kicad_pcb, f1-led-circuit.kicad_sch]
2024-04-11 Add draw.io block diagram
    [f1-led-circuit.kicad_sch]
2024-04-11 Add schematics block diagram
2024-04-11 KiCad - Add custom footprint and symbol - HD108-2020
    [f1-led-circuit.kicad_sch]
2024-04-12 KiCad - Add hierarchical sheets for RGB LED traks - daisy chains 1 through 8
    [f1-led-circuit.kicad_sch, rgb_led_track_chain.kicad_sch, rgb_led_track_chain_5.kicad_sch]
2024-04-12 KiCad - Save progress - RGB LED daisy chain
2024-04-12 KiCad - Update RGB LED Chains - 124 LEDS represented
    [f1-led-circuit.kicad_sch, rgb_led_track_chain.kicad_sch]
2024-04-16 KiCAD - Create Footprint and Symbol for LDLN050 - build LDO circuit
    [f1-led-circuit.kicad_sch, rgb_led_track_chain.kicad_sch]
2024-04-17 Add custom footprints
2024-04-17 Add footprint from STM download for LDO
    [f1-led-circuit.kicad_sch]
2024-04-17 Add starting light LEDS
    [f1-led-circuit.kicad_sch]
2024-04-17 Kicad - Add 10-pin Debug Connector
    [f1-led-circuit.kicad_sch]
2024-04-18 KiCad - Connect Cortex 10-pin Debug Connector
    [f1-led-circuit.kicad_sch]
2024-04-18 KiCad - Add Analog Temperature Sensor
    [f1-led-circuit.kicad_sch]
2024-04-18 KiCad - Add footprints for 10-Pin JTAG Debug Conn and USB-C Conn
    [FTSH-105-01-L-DV-K-P-TR.stp, FTSH-105-XX-X-DV.step, f1-led-circuit.kicad_sch]
2024-04-18 KiCad - Add Start/Stop footprint and connect symbol to schematic
    [f1-led-circuit.kicad_sch]
2024-04-18 KiCad - Additional footprints in footprints directory. Begin P-Channel MOSFET as a Switch
    [f1-led-circuit.kicad_sch]
2024-04-19 KiCad - Complete Power On/Off Switch
    [f1-led-circuit.kicad_sch]
2024-04-19 KiCad - Add Boot with options for SPST pushbutton or DPST switch + STPST pushbutton
    [f1-led-circuit.kicad_sch]
2024-04-19 KiCad - Fix connections for ERC
    [f1-led-circuit.kicad_sch]
2024-04-19 KiCad - Remove switch/button combo for BOOT
    [f1-led-circuit.kicad_sch]
2024-04-24 KiCad - Fix ERC errors and add README.md
    [f1-led-circuit.kicad_sch]
2024-04-24 KiCad - Update README.md
2024-04-24 KiCad - ERC Error Free
    [f1-led-circuit.kicad_sch]
2024-04-24 KiCad - Update symbol library paths
    [f1-led-circuit.kicad_sch, rgb_led_track_chain.kicad_sch]
2024-04-26 KiCad - Update per Design Review Comments
    [f1-led-circuit.kicad_sch]
2024-04-29 KiCad - Fix pull-up resistors, ground jumper, clean labels, add decoupling capacitor DNI footprints to LEDs
    [f1-led-circuit.kicad_sch, rgb_led_track_chain.kicad_sch]
2024-04-30 KiCad - Add datasheets/part numbers. Update footprints
    [f1-led-circuit.kicad_sch]
2024-04-30 KiCad - Add missing footprints
    [NUF2042XV6T1G.STEP, USB4125-GF-A_REVA2.step, f1-led-circuit.kicad_pcb, f1-led-circuit.kicad_sch]
2024-04-30 KiCad - Load footprints onto PCB
    [f1-led-circuit.kicad_pcb, f1-led-circuit.kicad_sch]
2024-04-30 KiCad - Update reference numbers for LEDs
    [f1-led-circuit.kicad_sch, rgb_led_track_chain.kicad_sch]
2024-05-01 KiCad - experiment branch. Place footprints on pcb.
    [f1-led-circuit.kicad_pcb, f1-led-circuit.kicad_sch]
2024-05-01 KiCad - Update R2 footprint
    [f1-led-circuit.kicad_pcb]
2024-05-02 KiCad - Replace USB-C footprint
    [f1-led-circuit.kicad_pcb, f1-led-circuit.kicad_sch]
2024-05-02 KiCad - Update layout
    [f1-led-circuit.kicad_pcb]
2024-05-02 KiCad - Update JTag footprint
    [f1-led-circuit.kicad_pcb, f1-led-circuit.kicad_sch]
2024-05-02 KiCad - Add python scripts for x-y coords
    [f1-led-circuit.kicad_pcb, f1-led-circuit.kicad_sch]
2024-05-02 KiCad - Add net-ties for SPI/JTAG
    [f1-led-circuit.kicad_pcb, f1-led-circuit.kicad_sch]
2024-05-03 KiCad - Update place_leds.py
2024-05-03 KiCad - Update footprint origin for LEDs
    [f1-led-circuit.kicad_pcb]
2024-05-06 KiCad - Rotate U1-U6 LEDs
    [f1-led-circuit.kicad_pcb]
2024-05-06 KiCad - Replace LEDs
    [f1-led-circuit.kicad_pcb]
2024-05-06 KiCad - Update schematic - LED Pins
    [f1-led-circuit.kicad_pcb, f1-led-circuit.kicad_sch]
2024-05-06 KiCad - Update schematic - LED Pins Fix
    [f1-led-circuit.kicad_sch, rgb_led_track_chain.kicad_sch]
2024-05-06 KiCad - Update pcb - U1 - U6 LEDs
    [f1-led-circuit.kicad_pcb]
2024-05-06 KiCad - Add track user layer drawing
    [f1-led-circuit.kicad_pcb]
2024-05-06 KiCad - U1 - U13 aligned to track
    [f1-led-circuit.kicad_pcb]
2024-05-06 KiCad - U14 - U21 aligned to track
    [f1-led-circuit.kicad_pcb]
2024-05-06 KiCad - U22 - U34 aligned to track
    [f1-led-circuit.kicad_pcb]
2024-05-06 KiCad - U22 - U55 aligned to track
    [f1-led-circuit.kicad_pcb]
2024-05-06 KiCad - U56 - U73 aligned to track
    [f1-led-circuit.kicad_pcb]
2024-05-06 KiCad - U74 - U84 aligned to track
    [f1-led-circuit.kicad_pcb]
2024-05-06 KiCad - U85 - U90 aligned to track
    [f1-led-circuit.kicad_pcb]
2024-05-06 KiCad - U91 - U96 aligned to track
    [f1-led-circuit.kicad_pcb]
2024-05-07 KiCad - reposition U86 - U96 to fix deviation
    [f1-led-circuit.kicad_pcb]
2024-05-07 KiCad - Update get_x_y_from_kicad.py to include component angle
    [f1-led-circuit.kicad_pcb]
2024-05-07 KiCad - Route SPI and lay ground vias
    [f1-led-circuit.kicad_pcb]
2024-05-07 KiCad - rearrange MCU, boot, etc pcb layout
    [f1-led-circuit.kicad_pcb]
2024-05-08 KiCad - route power
    [f1-led-circuit.kicad_pcb]
2024-05-08 KiCad - route buttons
    [f1-led-circuit.kicad_pcb]
2024-05-08 KiCad - route all components minus LED 5V rails
    [f1-led-circuit.kicad_pcb]
2024-05-08 KiCad - place +5V vias for leds U1 - U64
    [f1-led-circuit.kicad_pcb]
2024-05-08 KiCad - place +5V vias for leds U65 - U96
    [f1-led-circuit.kicad_pcb]
2024-05-08 KiCad - route all +5V rails to LEDs
    [f1-led-circuit.kicad_pcb]
2024-05-11 KiCad - move power switch and update power tracks
    [f1-led-circuit.kicad_pcb]
2024-05-11 KiCad - bring power tracks from B.Cu up to F.Cu
    [f1-led-circuit.kicad_pcb]
2024-05-11 KiCad - remove Vias for B.Cu to F.Cu for power tracks
    [f1-led-circuit.kicad_pcb]
2024-05-11 KiCad - Add capacitors to power tracks
    [f1-led-circuit.kicad_pcb]
2024-05-13 KiCad - Complete capacitors on power tracks to leds
    [f1-led-circuit.kicad_pcb]
2024-05-13 KiCad - Redraw power tracks to leds using direct connects to +5V rail
    [f1-led-circuit.kicad_pcb]
2024-05-13 KiCad - Add USB4105-GF-A footprint to footprint library
    [f1-led-circuit.kicad_pcb]
2024-05-13 KiCad - Move power components higher and change to new USB-C
    [f1-led-circuit.kicad_pcb]
2024-05-13 KiCad - Move power button for clearance
    [f1-led-circuit.kicad_pcb]
2024-05-13 KiCad - Fix DRC violations
    [f1-led-circuit.kicad_pcb, f1-led-circuit.kicad_sch, rgb_led_track_chain.kicad_sch]
2024-05-13 KiCad - Update data sheet and part number for USB-C in schematic
    [f1-led-circuit.kicad_sch, rgb_led_track_chain.kicad_sch]
2024-05-13 KiCad - Add copper pour to GNDs on MCU
    [f1-led-circuit.kicad_pcb]
2024-05-13 KiCad - Fix DRC errors
    [f1-led-circuit.kicad_pcb]
2024-05-13 KiCad - schematic - remove extra leds
    [f1-led-circuit.kicad_pcb, f1-led-circuit.kicad_sch]
2024-05-14 KiCad - Re-run ERC and DRC - Error free - J1 and J2 need nets in footprints in case of footprints reimport from schematics
    [f1-led-circuit.kicad_pcb]
2024-05-14 KiCad - Add datasheets to schematic components
    [f1-led-circuit.kicad_sch]
2024-05-14 KiCad - bring B.Cu layers to F.Cu layers near MCU - reroute
    [f1-led-circuit.kicad_pcb]
2024-05-14 KiCad - Move JTAG and Jumper - re-route
    [f1-led-circuit.kicad_pcb]
2024-05-14 KiCad - Move R3 - reroute START/STOP track
    [f1-led-circuit.kicad_pcb]
2024-05-14 KiCad - Move R3 to side of USB-C
    [f1-led-circuit.kicad_pcb]
2024-05-14 KiCad - realign GND vias under MCU
    [f1-led-circuit.kicad_pcb]
2024-05-14 KiCad - copper pour on EN pads
    [f1-led-circuit.kicad_pcb]
2024-05-15 KiCad - Add MPN for leds in schematic
    [f1-led-circuit.kicad_sch, rgb_led_track_chain.kicad_sch]
2024-05-15 KiCad - Add description for LDO
    [f1-led-circuit.kicad_sch]
2024-05-15 KiCad - Apply worksheet template to add logo
    [f1-led-circuit.kicad_pcb, f1-led-circuit.kicad_sch]
2024-05-15 KiCad - resize silkscreen for led designators
    [f1-led-circuit.kicad_pcb]
2024-05-15 KiCad - resize silkscreen for capacitors and resistors
    [f1-led-circuit.kicad_pcb]
2024-05-15 KiCad - update setup to new silkscreen text size
    [f1-led-circuit.kicad_pcb]
2024-05-15 KiCad - move SW3 silkscreen
    [f1-led-circuit.kicad_pcb]
2024-05-15 KiCad repour
2024-05-15 KiCad - Add silkscreen logo, name, rev number
    [f1-led-circuit.kicad_pcb]
2024-05-15 KiCad - remove .psd and .png files for logo
2024-05-15 KiCad - generate and zip gerber and drill files
    [f1-led-circuit-B_Cu.gbr, f1-led-circuit-B_Mask.gbr, f1-led-circuit-B_Paste.gbr, f1-led-circuit-B_Silkscreen.gbr, f1-led-circuit-Edge_Cuts.gbr, f1-led-circuit-F_Cu.gbr, f1-led-circuit-F_Mask.gbr, f1-led-circuit-F_Paste.gbr]
2024-05-15 KiCad - generate bom
    [f1-led-circuit.kicad_pcb]
2024-05-16 KiCad - update schematic symbols and footprints to match
    [f1-led-circuit.kicad_pcb, f1-led-circuit.kicad_sch]
2024-05-16 KiCad - new gerbers and bom
    [f1-led-circuit-B_Cu.gbr, f1-led-circuit-B_Mask.gbr, f1-led-circuit-B_Paste.gbr, f1-led-circuit-B_Silkscreen.gbr, f1-led-circuit-Edge_Cuts.gbr, f1-led-circuit-F_Cu.gbr, f1-led-circuit-F_Mask.gbr, f1-led-circuit-F_Paste.gbr]
2024-05-17 KiCad - update datasheet links in schema
    [f1-led-circuit-B_Cu.gbr, f1-led-circuit-B_Mask.gbr, f1-led-circuit-B_Paste.gbr, f1-led-circuit-B_Silkscreen.gbr, f1-led-circuit-Edge_Cuts.gbr, f1-led-circuit-F_Cu.gbr, f1-led-circuit-F_Mask.gbr, f1-led-circuit-F_Paste.gbr]
2024-05-20 Rust App - add base working example (#10)
    * Rust App - add base working example
    ---------
    [430182043816.stp, 430182070816.stp, AS13AP.stp, ESP32-C3-MINI-1-N4.step, FTSH-105-01-L-DV-K-P-TR.stp, FTSH-105-01-L-DV-K-TR.step, FTSH-105-XX-X-DV.step, HD108-2020.step]
2024-05-20 Cleanup schematics and redundant vias in PCB
    [f1-led-circuit.kicad_pcb, f1-led-circuit.kicad_sch, rgb_led_track_chain.kicad_sch]
2024-05-20 Update HD108-2020 footprint with pin 1 marking
    [f1-led-circuit.kicad_pcb, f1-led-circuit.kicad_sch]
2024-05-21 Update ESP32 part number
    [f1-led-circuit.kicad_sch]
2024-05-21 Fix Issue #12 - Rename directories
    [430182043816.stp, 430182070816.stp, AS13AP.stp, ESP32-C3-MINI-1-N4.step, FTSH-105-01-L-DV-K-TR.step, HD108-2020.step, LDLN050PU33R.step, NUF2042XV6T1G.STEP]
2024-05-21 Fix issue #16 - run cargo fmt
    [main.rs]
2024-05-21 Fix issue #16 - remove println
2024-05-22 Fix issue #16 - add .cargo/config.toml - update .gitignore - move .vscode dir
    [main.rs]
2024-05-31 Update temperature sensor part number
    [f1-led-circuit.kicad_sch]
2024-06-14 Reorganize project - start coding real board
2024-06-14 Add HD108 driver - incomplete
2024-06-14 Change spi config
2024-06-17 Add SpiDma functionality - needs 1 fix
    [main.rs]
2024-06-18 Update to simpler example without lifetime issues
    [main.rs]
2024-06-18 Simple led working example
2024-06-19 Set LED gain level
2024-06-19 Changed LED gain level
2024-06-19 Light all LEDs
2024-06-19 Fix - led loop works
    [main.rs]
2024-06-19 Update SPI clock rate
2024-06-19 Add rgb argument to set_led function, loop through driver colors
2024-06-19 Add async task - need lifetime fix
    [main.rs]
2024-06-20 Async task fixed with static cell
    [main.rs]
2024-06-20 Add asybc button press task - need fix
    [main.rs]
2024-06-20 Fix async button press - works
    [main.rs]
2024-06-20 Fix async button press
    [main.rs]
2024-06-20 Application state setting to true and running reds upon button press - needs fix
    [main.rs]
2024-06-21 Start/Stop button work - need fix off channel message send needs to break running loop
    [main.rs]
2024-06-21 Remove atomic bool for application state - Consolidate to one signal with enum for messages - Need fix
    [main.rs]
2024-06-21 Fix - asycn start-stop button fully functional
    [main.rs]
2024-06-21 Start/Stop button working - simpler code
2024-06-25 Make data CONST, error needs fix
    [main.rs]
2024-06-26 Update data CONST, needs fix
    [main.rs]
2024-08-01 40 use binary data to visualize leds (#41)
    * Update .gitignore
    * Add most recent f1-simulation, f1-hardware (driver_info.rs, output.bin, update hd108.rs)
2024-08-03 Create seaparate 20x20 and 10x10 Kicad projects in kicad root
    [f1-led-circuit-10x10.kicad_pcb, f1-led-circuit-10x10.kicad_sch, f1-led-circuit_20x20.kicad_pcb, f1-led-circuit_20x20.kicad_sch, rgb_led_track_chain.kicad_sch, rgb_led_track_chain_5.kicad_sch]
2024-08-03 Add additional LEDs through hierarchical sheets
    [f1-led-circuit_20x20.kicad_sch, rgb_led_track_chain.kicad_sch]
2024-08-03 Add test points for jumper and JTAG
    [f1-led-circuit_20x20.kicad_sch, rgb_led_track_chain.kicad_sch, rgb_led_track_chain_5_10x10.kicad_sch]
2024-08-04 Add leds to schematic and place in layout
    [f1-led-circuit_20x20.kicad_pcb, f1-led-circuit_20x20.kicad_sch, rgb_led_track_chain.kicad_sch]
2024-08-05 Move power components to B.Cu and route
    [f1-led-circuit_20x20.kicad_pcb, f1-led-circuit_20x20.kicad_sch]
2024-08-05 Update part number for MCU
    [f1-led-circuit_20x20.kicad_pcb, f1-led-circuit_20x20.kicad_sch]
2024-08-05 KiCad - Update designator numbers for LEDS
    [f1-led-circuit_20x20.kicad_pcb, f1-led-circuit_20x20.kicad_sch, rgb_led_track_chain.kicad_sch]
2024-08-05 pin_mv reading inside led_task
2024-08-06 Add temperature_task - Needs fix with arguments
    [main.rs]
2024-08-06 Fix temperature task
2024-08-06 Change calibration scheme to AdcCalLine
2024-08-06 Change AdcCalLine to global scope and refer to it in main and temperature task
2024-08-07 Add method to set all leds on
2024-08-07 Fix for 96th led
    [main.rs]
2024-08-08 Update pcb layout
    [f1-led-circuit_20x20.kicad_pcb]
2024-08-08 Add Boot with Test Points
    [f1-led-circuit_20x20.kicad_sch]
2024-08-08 Update test points - Add 3D models - Update SON_2XV6T1G_ONS.kicad_mod footprint
    [f1-led-circuit_20x20.kicad_pcb, f1-led-circuit_20x20.kicad_sch]
2024-08-08 Update leds in pcb layout from schematic and place again
    [f1-led-circuit_20x20.kicad_pcb]
2024-08-08 Add to test points +3.3V and GND
    [f1-led-circuit_20x20.kicad_pcb, f1-led-circuit_20x20.kicad_sch]
2024-08-08 Remove power switch from schematic
    [f1-led-circuit_20x20.kicad_pcb, f1-led-circuit_20x20.kicad_sch]
2024-08-08 Annotate schematic again and update PCB layout
    [f1-led-circuit_20x20.kicad_pcb, f1-led-circuit_20x20.kicad_sch]
