JitterCompany/f1-led-circuit/(notices)

Notices in the files:
kicad/3D models/AS13AP.stp:
author */ ('License CC BY-ND 4.0'),
